santkumar/uPatternScope/hardware/metallic_components/heat_sink/heat_sink_back.jpg

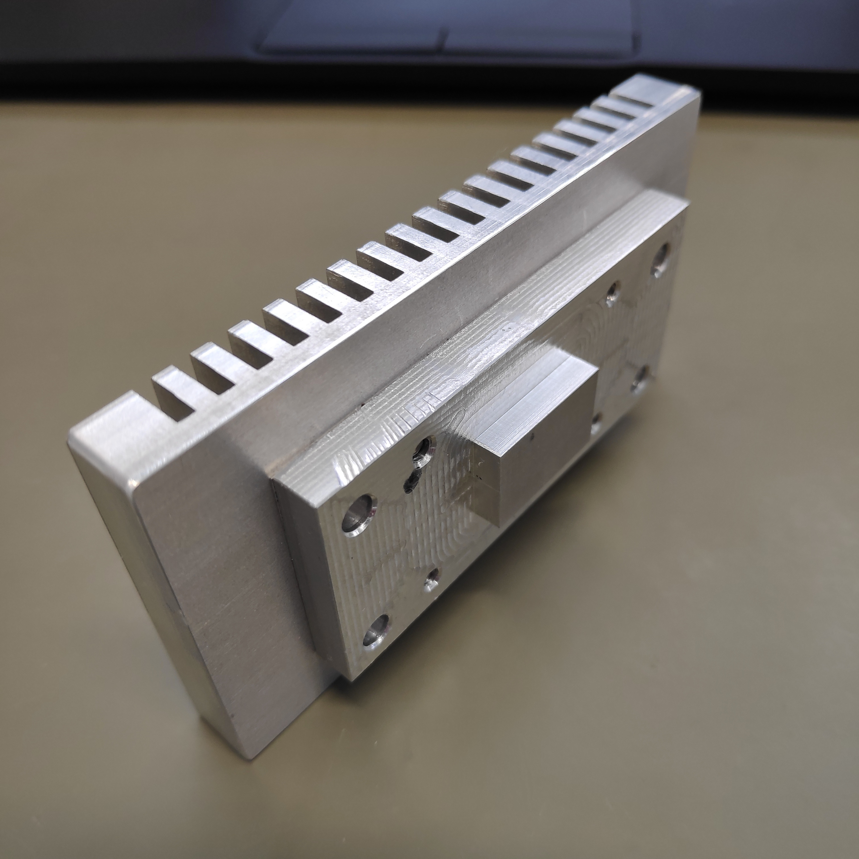
hardware/metallic_components/heat_sink/heat_sink_back.jpg
