santkumar/uPatternScope/README.md

- Hardware: Parts list, CAD designs and related files for the uPatterScope hardware
- Software: Software routines for different demonstration experiments
