santkumar/uPatternScope/hardware/3D_CAD_render1.png

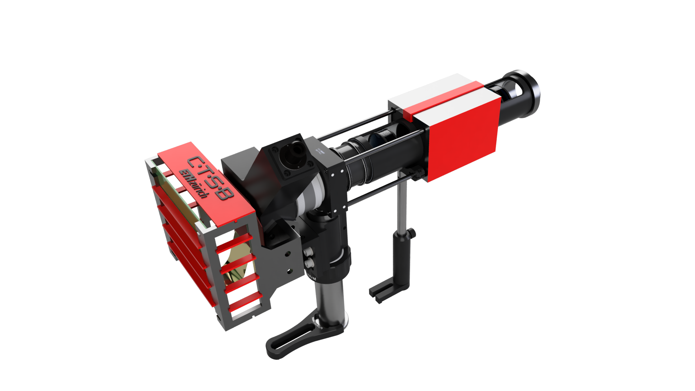
hardware/3D_CAD_render1.png
