santkumar/uPatternScope/hardware/3D_CAD_render2.png

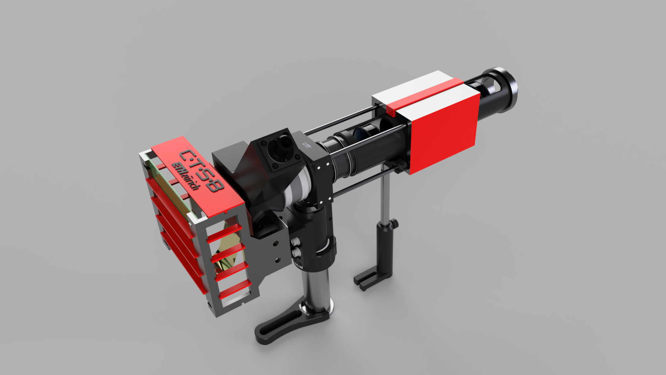
hardware/3D_CAD_render2.png
