santkumar/uPatternScope/software/segmentation_and_pattern_projection/bri_image.png

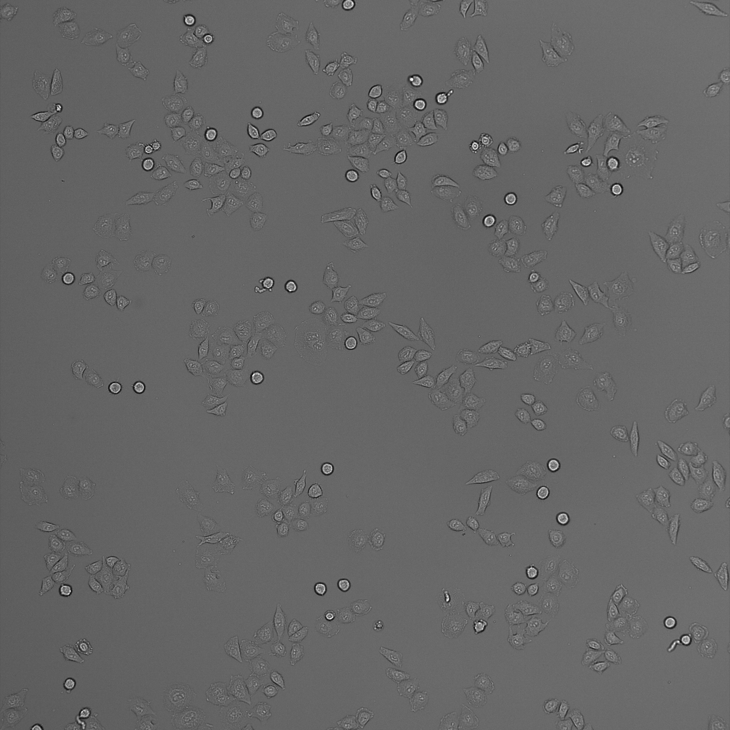
software/segmentation_and_pattern_projection/bri_image.png
