santkumar/uPatternScope/software/segmentation_and_pattern_projection/seg_image.png

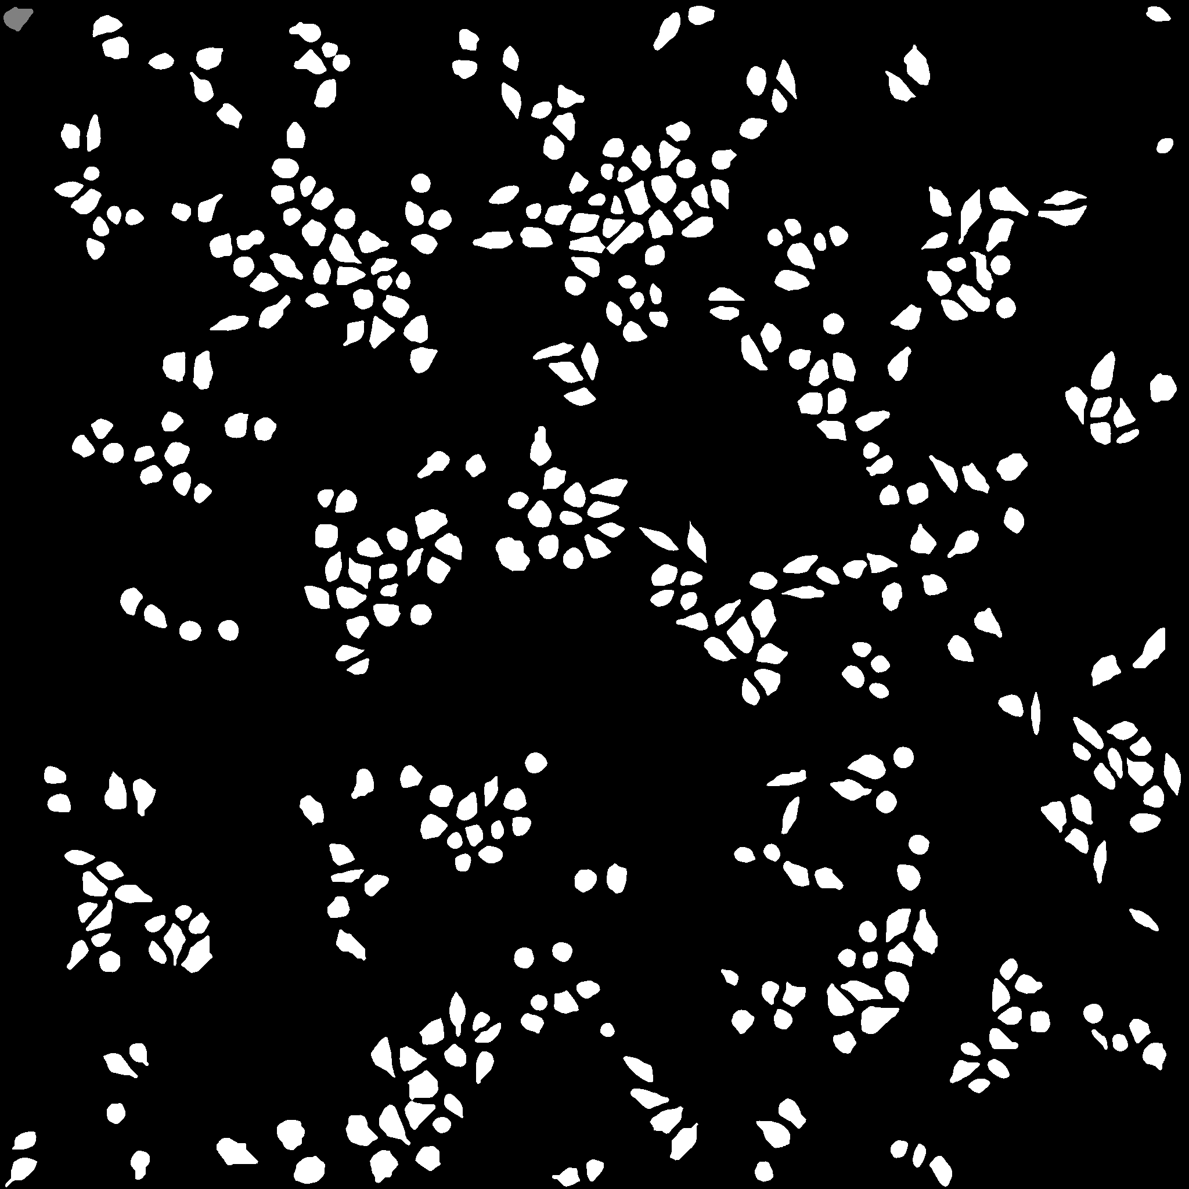
software/segmentation_and_pattern_projection/seg_image.png
