santkumar/uPatternScope/software/segmentation_and_pattern_projection/seg_image.tif

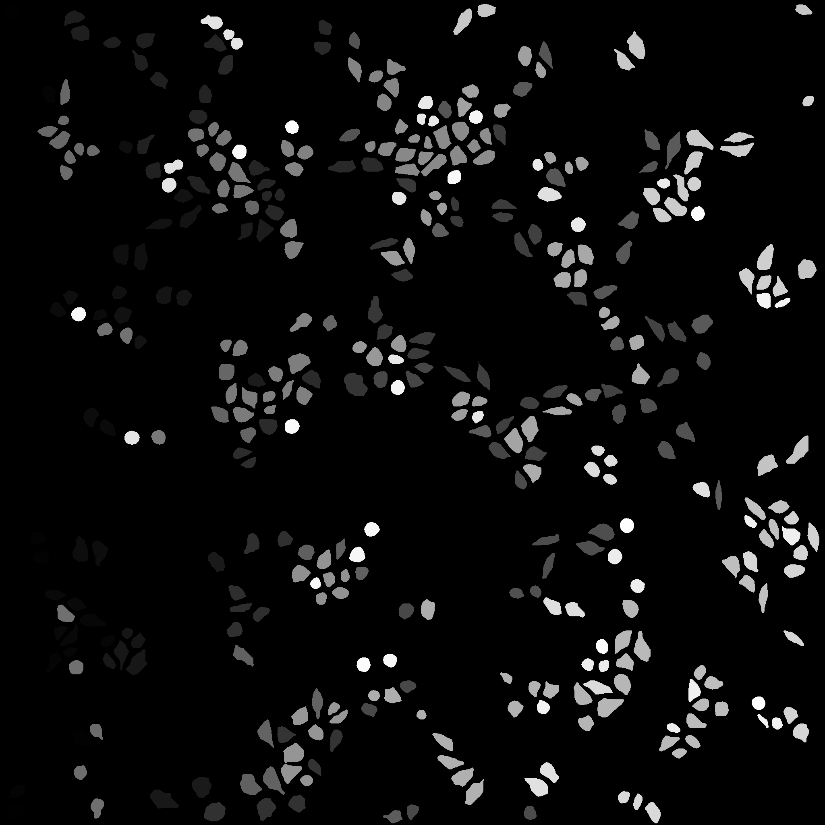
software/segmentation_and_pattern_projection/seg_image.tif
