santkumar/uPatternScope/software/tictactoe_game_matlab_routines/to_project/circle_corrected.png

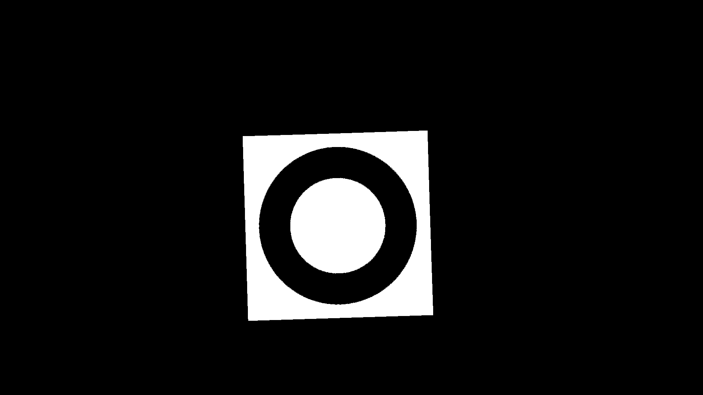
software/tictactoe_game_matlab_routines/to_project/circle_corrected.png
