santkumar/uPatternScope/software/tictactoe_game_matlab_routines/to_project/cross_corrected.png

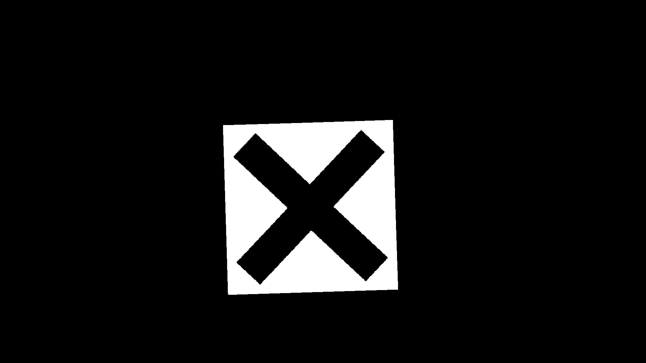
software/tictactoe_game_matlab_routines/to_project/cross_corrected.png
