santkumar/uPatternScope/hardware/Thorlabs_Shopping_Cart.xlsx

Part Number | Item | Product URL | Qty | Price | Subtotal | Currency
M450LP1 | 450 nm 1850 mW (Min) Mounted LED 2000 mA | https://www.thorlabs.com/newgrouppage9.cfm?objectgroup_id=2692 | 1 | 296.08 | 296.08 | Euro
LEDD1B | T-Cube LED Driver 1200 mA Max Drive Current (Power Supply Not Included) | https://www.thorlabs.com/newgrouppage9.cfm?objectgroup_id=2616 | 1 | 294.11 | 294.11 | Euro
KPS101 | 15 V 2.4 A Power Supply Unit with 3.5 mm Jack Connector for One K- or T-Cube | https://www.thorlabs.com/newgrouppage9.cfm?objectgroup_id=1710 | 1 | 32.14 | 32.14 | Euro
SM1L10 | SM1 Lens Tube 1.00" Thread Depth One Retaining Ring Included | https://www.thorlabs.com/newgrouppage9.cfm?objectgroup_id=3307 | 1 | 13.34 | 13.34 | Euro
LLG5-6H | Liquid Light Guide Ø5 mm Core 340 - 800 nm 6' (1.8 m) Length | https://www.thorlabs.com/newgrouppage9.cfm?objectgroup_id=4273 | 1 | 527.23 | 527.23 | Euro
AD5LLG | Ø5 mm LLG to SM1 Adapter | https://www.thorlabs.com/newgrouppage9.cfm?objectgroup_id=4273 | 2 | 31.73 | 63.46 | Euro
XT34SM1 | SM1 Adapter Face Plate for 34 mm Rails Four M3 Screws Included | https://www.thorlabs.com/newgrouppage9.cfm?objectgroup_id=1827 | 1 | 27.54 | 27.54 | Euro
C1515/M | Ø1.5" Mounting Post Bracket M6 Taps | https://www.thorlabs.com/newgrouppage9.cfm?objectgroup_id=1310 | 1 | 97.38 | 97.38 | Euro
HW-KIT2/M | M6 Cap Screw and Hardware Kit | https://www.thorlabs.com/newgrouppage9.cfm?objectgroup_id=248 | 1 | 110.17 | 110.17 | Euro
PSHA/M | Adjustable Height Collar for Ø1.5" Posts M6 x 1.0 Locking Screw | https://www.thorlabs.com/newgrouppage9.cfm?objectgroup_id=1310 | 1 | 62.96 | 62.96 | Euro
C15QR/M | Quick Release Handle 51.4 mm Long M6 x 1.0 Threads | https://www.thorlabs.com/newgrouppage9.cfm?objectgroup_id=9134 | 1 | 9.54 | 9.54 | Euro
RSPC | Fixed Position Retainer | https://www.thorlabs.com/newgrouppage9.cfm?objectgroup_id=47 | 1 | 9.04 | 9.04 | Euro
PB4/M | Studded Pedestal Base Adapter M6 x 1.0 Thread | https://www.thorlabs.com/newgrouppage9.cfm?objectgroup_id=887 | 1 | 12.49 | 12.49 | Euro
PF175B | Clamping Fork for Ø1.5" Pedestal Post or Post Pedestal Base Adapter Universal | https://www.thorlabs.com/newgrouppage9.cfm?objectgroup_id=887 | 1 | 15.45 | 15.45 | Euro
LCP11/M | 60 mm Cage Plate Internal and External SM2 Threads M4 Tap (One SM2RR Retaining Ring Included) | https://www.thorlabs.com/newgrouppage9.cfm?objectgroup_id=3021 | 1 | 95.67 | 95.67 | Euro
SM2L30C | SM2 Slotted Lens Tube 3" Thread Depth 2 Retaining Rings Included | https://www.thorlabs.com/newgrouppage9.cfm?objectgroup_id=3383 | 1 | 88.53 | 88.53 | Euro
SM2T20 | SM2 (2.035"-40) Coupler External Threads 2" Long | https://www.thorlabs.com/newgrouppage9.cfm?objectgroup_id=2704 | 1 | 37.14 | 37.14 | Euro
LCP01/M | 60 mm Cage Plate SM2 Threads 0.5" Thick M4 Tap (Two SM2RR Retaining Rings Included) | https://www.thorlabs.com/newgrouppage9.cfm?objectgroup_id=3021 | 5 | 37.38 | 186.9 | Euro
SM2L20C | SM2 Slotted Lens Tube 2" Thread Depth 2 Retaining Rings Included | https://www.thorlabs.com/newgrouppage9.cfm?objectgroup_id=3383 | 1 | 77.46 | 77.46 | Euro
SM2D25D | SM2 Ring-Actuated Iris Diaphragm (Ø1 - Ø25 mm) | https://www.thorlabs.com/newgrouppage9.cfm?objectgroup_id=1479 | 1 | 81.4 | 81.4 | Euro
LCP01B | 60 mm Cage Mounting Bracket | https://www.thorlabs.com/newgrouppage9.cfm?objectgroup_id=4122 | 1 | 29.27 | 29.27 | Euro
TR150/M | Ø12.7 mm Optical Post SS M4 Setscrew M6 Tap L = 150 mm | https://www.thorlabs.com/newgrouppage9.cfm?objectgroup_id=1266 | 1 | 6.66 | 6.66 | Euro
UPH150/M | Ø12.7 mm Universal Post Holder Spring-Loaded Locking Thumbscrew L = 150 mm | https://www.thorlabs.com/newgrouppage9.cfm?objectgroup_id=1982 | 1 | 35.41 | 35.41 | Euro
LCPA1 | 60 mm Cage Alignment Plate with Ø1 mm Hole | https://www.thorlabs.com/newgrouppage9.cfm?objectgroup_id=7296 | 1 | 17.61 | 17.61 | Euro
CA2824 | SMA Coaxial Cable SMA Male to BNC Male 24" (609 mm) | https://www.thorlabs.com/newgrouppage9.cfm?objectgroup_id=2888 | 1 | 15.83 | 15.83 | Euro
HW-KIT1/M | M4 Cap Screw and Hardware Kit | https://www.thorlabs.com/newgrouppage9.cfm?objectgroup_id=248 | 1 | 55.58 | 55.58 | Euro
ER12 | Cage Assembly Rod 12" Long Ø6 mm | https://www.thorlabs.com/newgrouppage9.cfm?objectgroup_id=4125 | 4 | 15.73 | 62.92 | Euro
AC508-075-A | f = 75 mm Ø2" Achromatic Doublet ARC: 400 - 700 nm | https://www.thorlabs.com/newgrouppage9.cfm?objectgroup_id=120 | 1 | 117.05 | 117.05 | Euro
AC508-100-A | f = 100 mm Ø2" Achromatic Doublet ARC: 400 - 700 nm | https://www.thorlabs.com/newgrouppage9.cfm?objectgroup_id=120 | 1 | 102.3 | 102.3 | Euro
AC508-080-A | f = 80 mm Ø2" Achromatic Doublet ARC: 400 - 700 nm | https://www.thorlabs.com/newgrouppage9.cfm?objectgroup_id=120 | 1 | 117.05 | 117.05 | Euro
MB2025/M | Aluminum Breadboard 200 mm x 250 mm x 12.7 mm M6 Taps | https://www.thorlabs.com/newgrouppage9.cfm?objectgroup_id=159 | 1 | 111.15 | 111.15 | Euro
P150/M | Ø1.5" Mounting Post M6 Taps L = 150 mm | https://www.thorlabs.com/newgrouppage9.cfm?objectgroup_id=1313 | 1 | 49.19 | 49.19 | Euro
P30/M | Ø1.5" Mounting Post M6 Taps L = 30 mm | https://www.thorlabs.com/newgrouppage9.cfm?objectgroup_id=1313 | 1 | 22.13 | 22.13 | Euro
