santkumar/uPatternScope/hardware/metallic_components/heat_sink/heat_sink_front.jpg

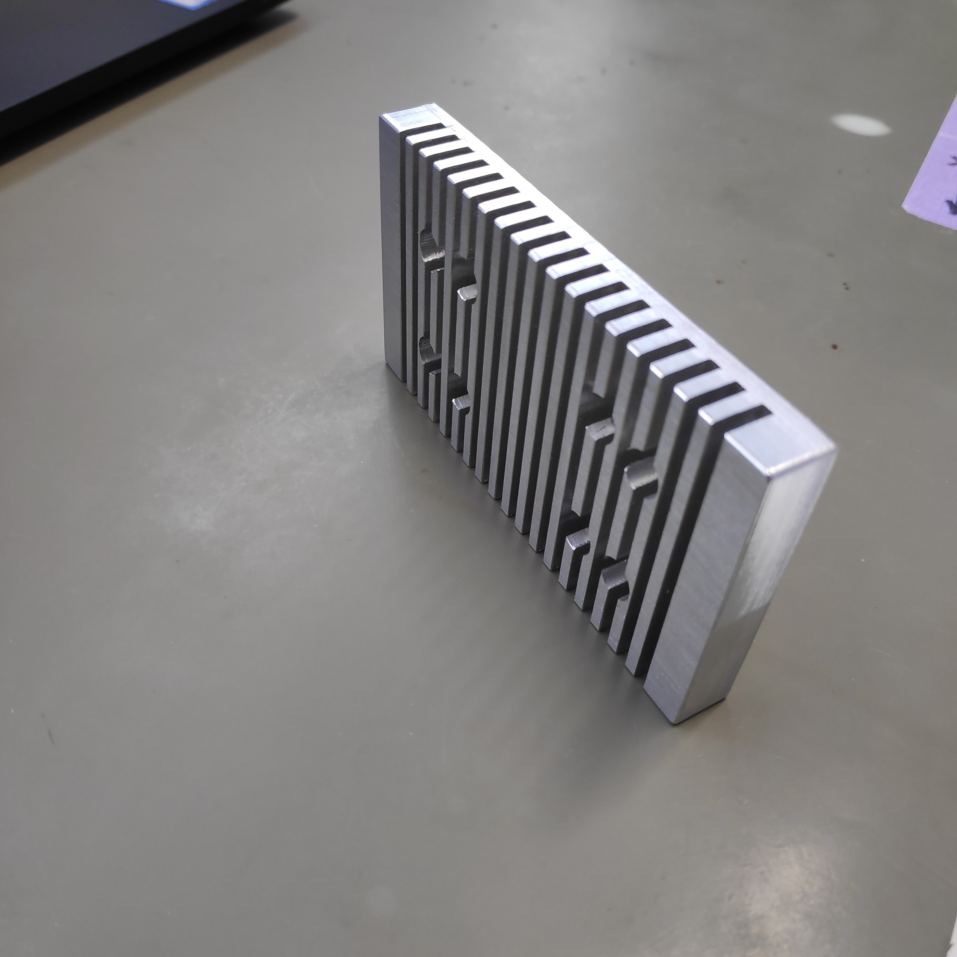
hardware/metallic_components/heat_sink/heat_sink_front.jpg
