santkumar/uPatternScope/hardware/CAD_files_for_3D_print/DMD_fancy_support_optional_2.stl

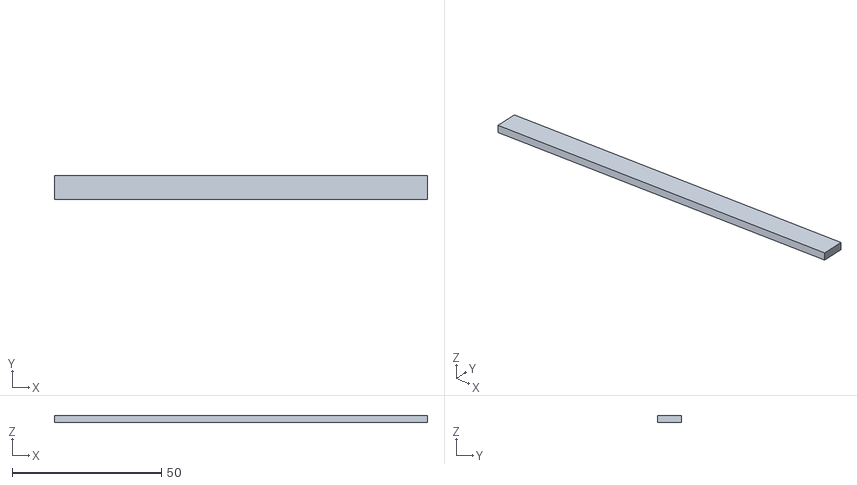
[picture p13: CAD file, 2024-02-26]
hardware/CAD_files_for_3D_print/DMD_fancy_support_optional_2.stl
125.0 x 8.00 x 2.50
