santkumar/uPatternScope/hardware/metallic_components/heat_sink/DMD_heat_sink.STEP

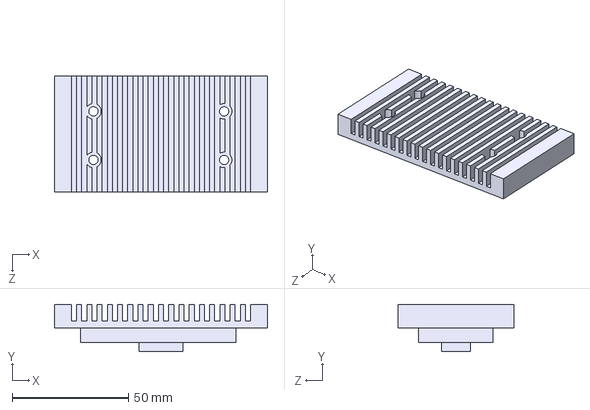
[picture p14: CAD file, 2024-02-26]
hardware/metallic_components/heat_sink/DMD_heat_sink.STEP
91.6 x 20.4 x 50.0 mm
