santkumar/uPatternScope/hardware/metallic_components/microscope_related/NikonTi2_LA_BF_adapter/TI2_LA_BF_adapter.step

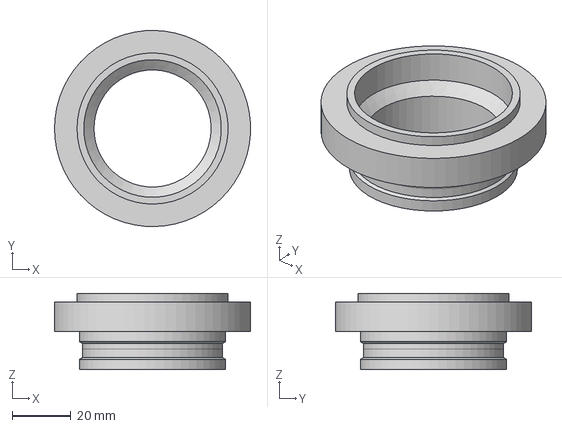
[picture p15: CAD file, 2024-02-26]
hardware/metallic_components/microscope_related/NikonTi2_LA_BF_adapter/TI2_LA_BF_adapter.step
67.0 x 67.0 x 26.0 mm
