santkumar/uPatternScope/hardware/CAD_files_for_3D_print/DMD_board_left_support.step

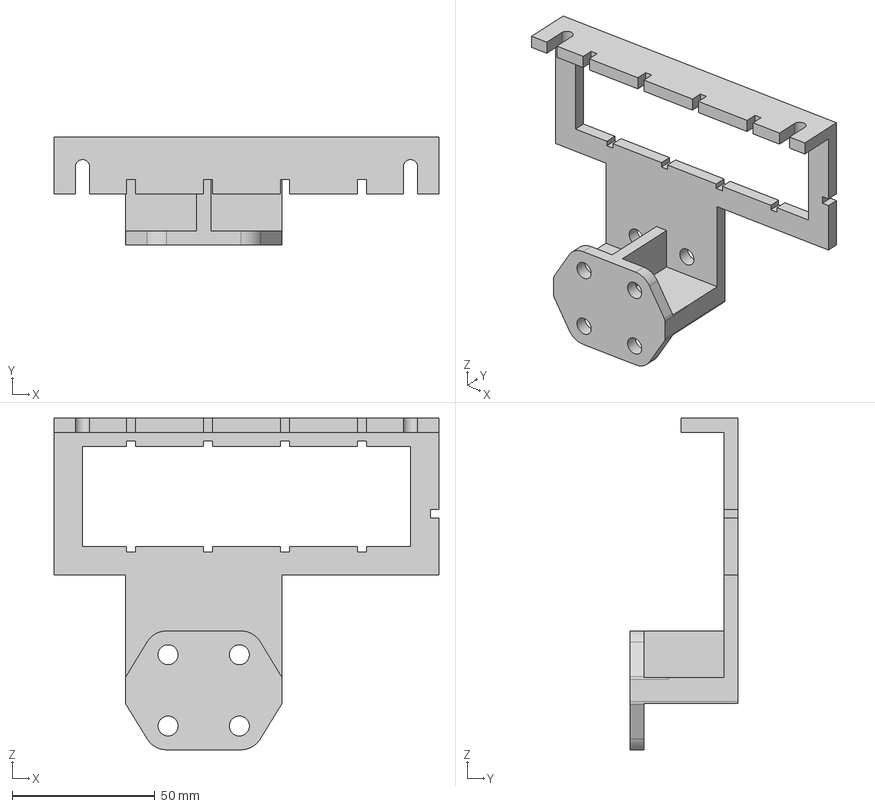
[picture p16: CAD file, 2024-02-26]
hardware/CAD_files_for_3D_print/DMD_board_left_support.step
135.0 x 38.0 x 116.3 mm
