santkumar/uPatternScope/hardware/CAD_files_for_3D_print/DMD_fancy_support_optional_1.stl

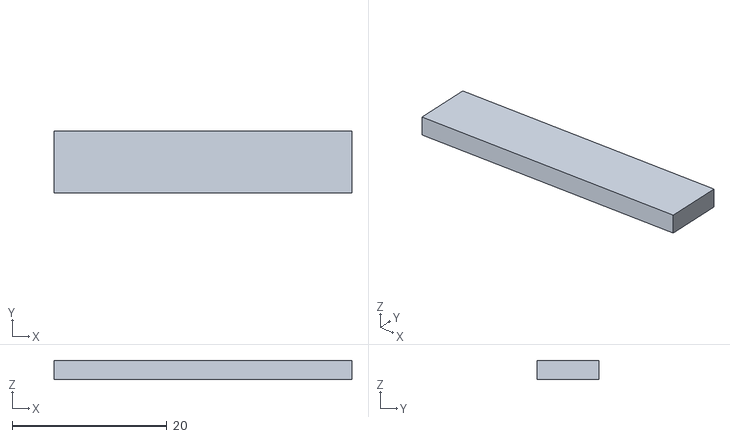
[picture p17: CAD file, 2024-02-26]
hardware/CAD_files_for_3D_print/DMD_fancy_support_optional_1.stl
38.5 x 8.00 x 2.50
