santkumar/uPatternScope/hardware/CAD_files_for_3D_print/DMD_fancy_support_optional.step

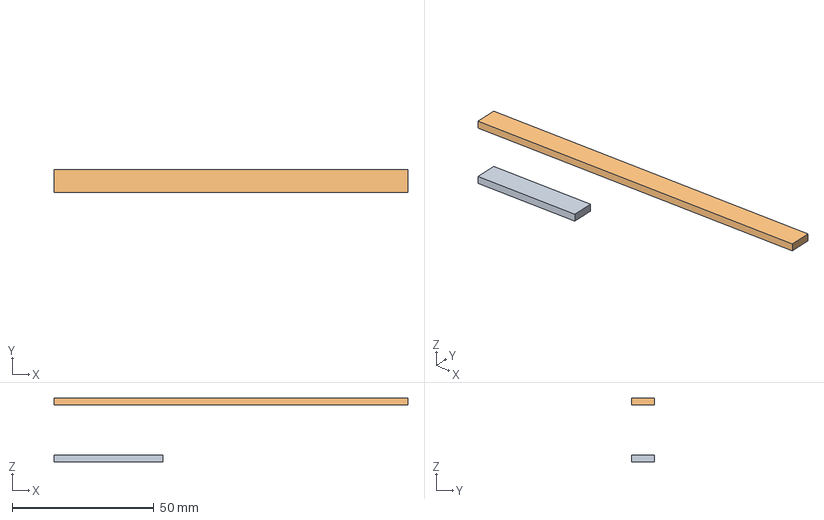
[picture p18: CAD file, 2024-02-26]
hardware/CAD_files_for_3D_print/DMD_fancy_support_optional.step
125.0 x 8.00 x 22.5 mm
