santkumar/uPatternScope/hardware/CAD_files_for_3D_print/optical_cage_cover.step

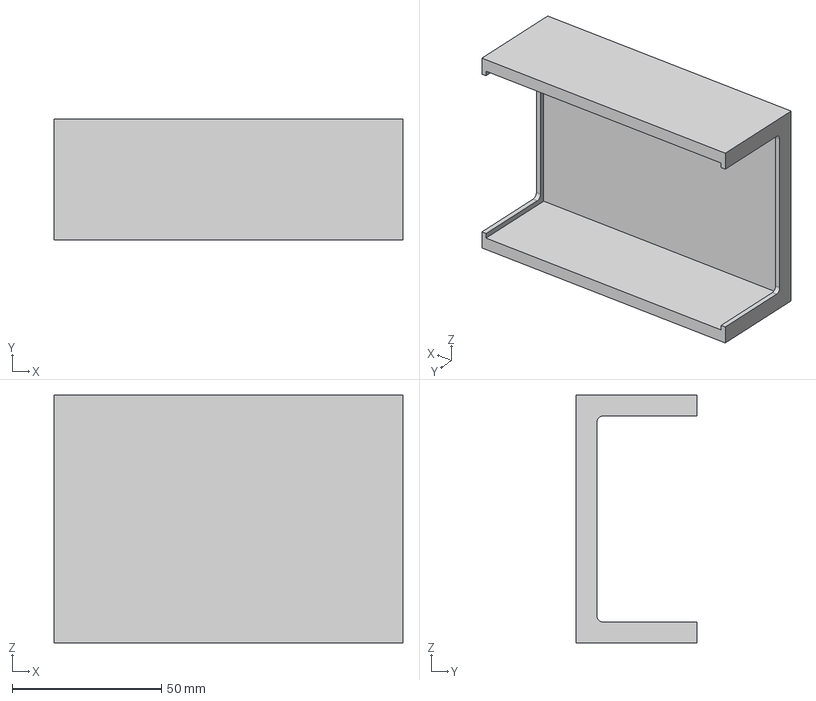
[picture p19: CAD file, 2024-02-26]
hardware/CAD_files_for_3D_print/optical_cage_cover.step
117.0 x 40.5 x 83.0 mm
