santkumar/uPatternScope/hardware/CAD_files_for_3D_print/optical_cage_cover_coupler.step

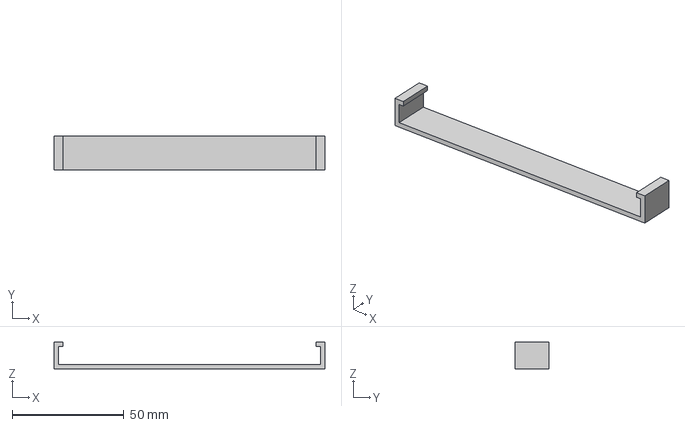
[picture p20: CAD file, 2024-02-26]
hardware/CAD_files_for_3D_print/optical_cage_cover_coupler.step
121.0 x 15.0 x 12.0 mm
