santkumar/uPatternScope/hardware/CAD_files_for_3D_print/logo_cover.step

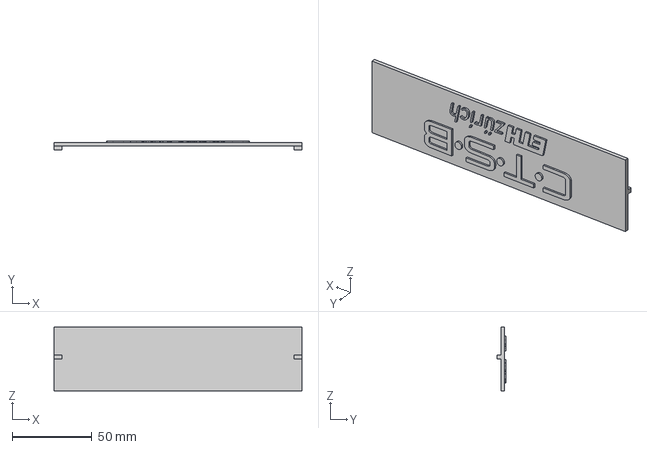
[picture p21: CAD file, 2024-02-26]
hardware/CAD_files_for_3D_print/logo_cover.step
155.5 x 5.50 x 40.0 mm
