santkumar/uPatternScope/hardware/CAD_files_for_3D_print/DMD_board_right_support.step

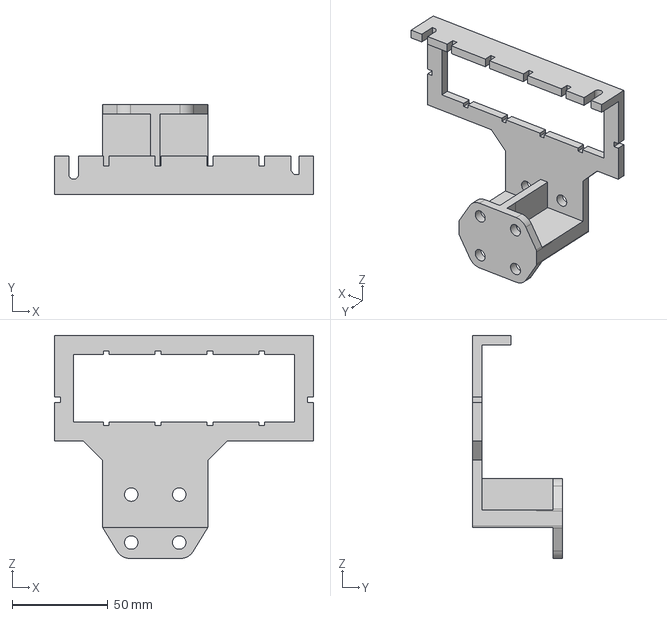
[picture p22: CAD file, 2024-02-26]
hardware/CAD_files_for_3D_print/DMD_board_right_support.step
135.0 x 47.0 x 116.3 mm
