santkumar/uPatternScope/(list of files, cad)

Other CAD files:
software/function_routines/driverDMD/hidapi/hidapi64_thunk_pcwin64.obj
software/segmentation_and_pattern_projection/driverDMD/hidapi/hidapi64_thunk_pcwin64.obj
software/tictactoe_game_matlab_routines/driverDMD/hidapi/hidapi64_thunk_pcwin64.obj
hardware/CAD_files_for_3D_print/DMD_board_left_support.stl
hardware/CAD_files_for_3D_print/DMD_board_right_support.stl
hardware/CAD_files_for_3D_print/logo_cover.stl
hardware/CAD_files_for_3D_print/optical_cage_cover.stl
hardware/CAD_files_for_3D_print/optical_cage_cover_coupler.stl
hardware/metallic_components/heat_sink/DMD_heat_sink.STL
hardware/metallic_components/microscope_related/NikonTi2_LA_BF_adapter/TI2_LA_BF_adapter.stl
