santkumar/uPatternScope/hardware/metallic_components/microscope_related/NikonTi2_LA_BF_adapter/TI2_LA_BF_adapter_technical_drawing.PDF

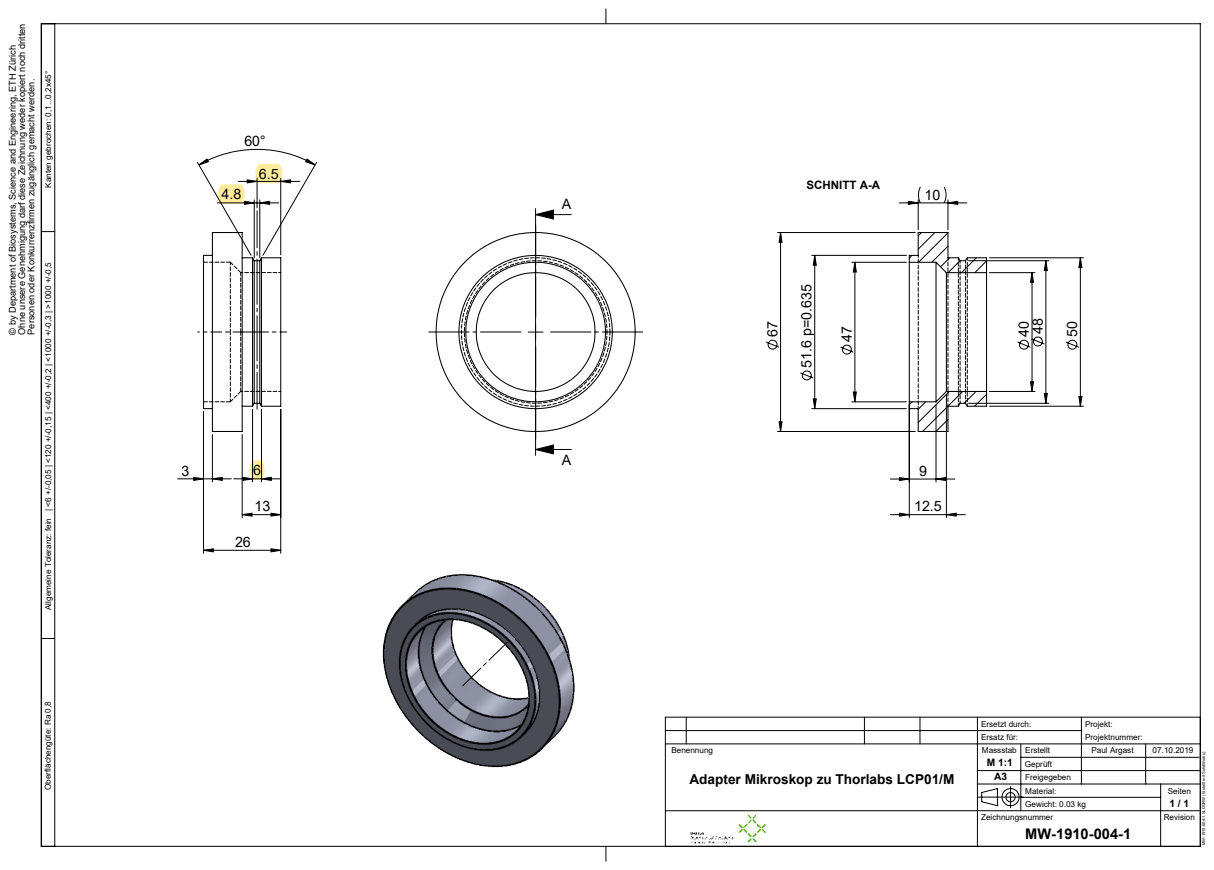
[picture p23: page 1]
10 SCHNITT A-A

Ohne unsere Genehmigung darf diese Zeichnung weder kopiert noch dritten

© by Department of Biosystems, Science and Engineering, ETH Zürich

Oberflächengüte: Ra 0,8 Kanten gebrochen: 0,1...0,2x45° Allgemeine Toleranz: fein | <6 +/-0,05 | <120 +/-0,15 | <400 +/-0,2 | <1000 +/-0,3 | >1000 +/-0,5

Personen oder Konkurrenzfirmen zugänglich gemacht werden.

Ersetzt durch: Projekt: Ersatz für: Projektnummer:

Benennung Adapter Mikroskop zu Thorlabs LCP01/M | Massstab Erstellt Paul Argast 07.10.2019 M 1:1 Geprüft A3 Freigegeben Material: Seiten 1 / 1 Gewicht: 0.03 kg

MW-1910-004-1.SLDDRW (Erstellt mit SolidWorks)

Zeichnungsnummer Revision MW-1910-004-1
