santkumar/uPatternScope/hardware/metallic_components/heat_sink/heat_sink_technical_drawing.pdf

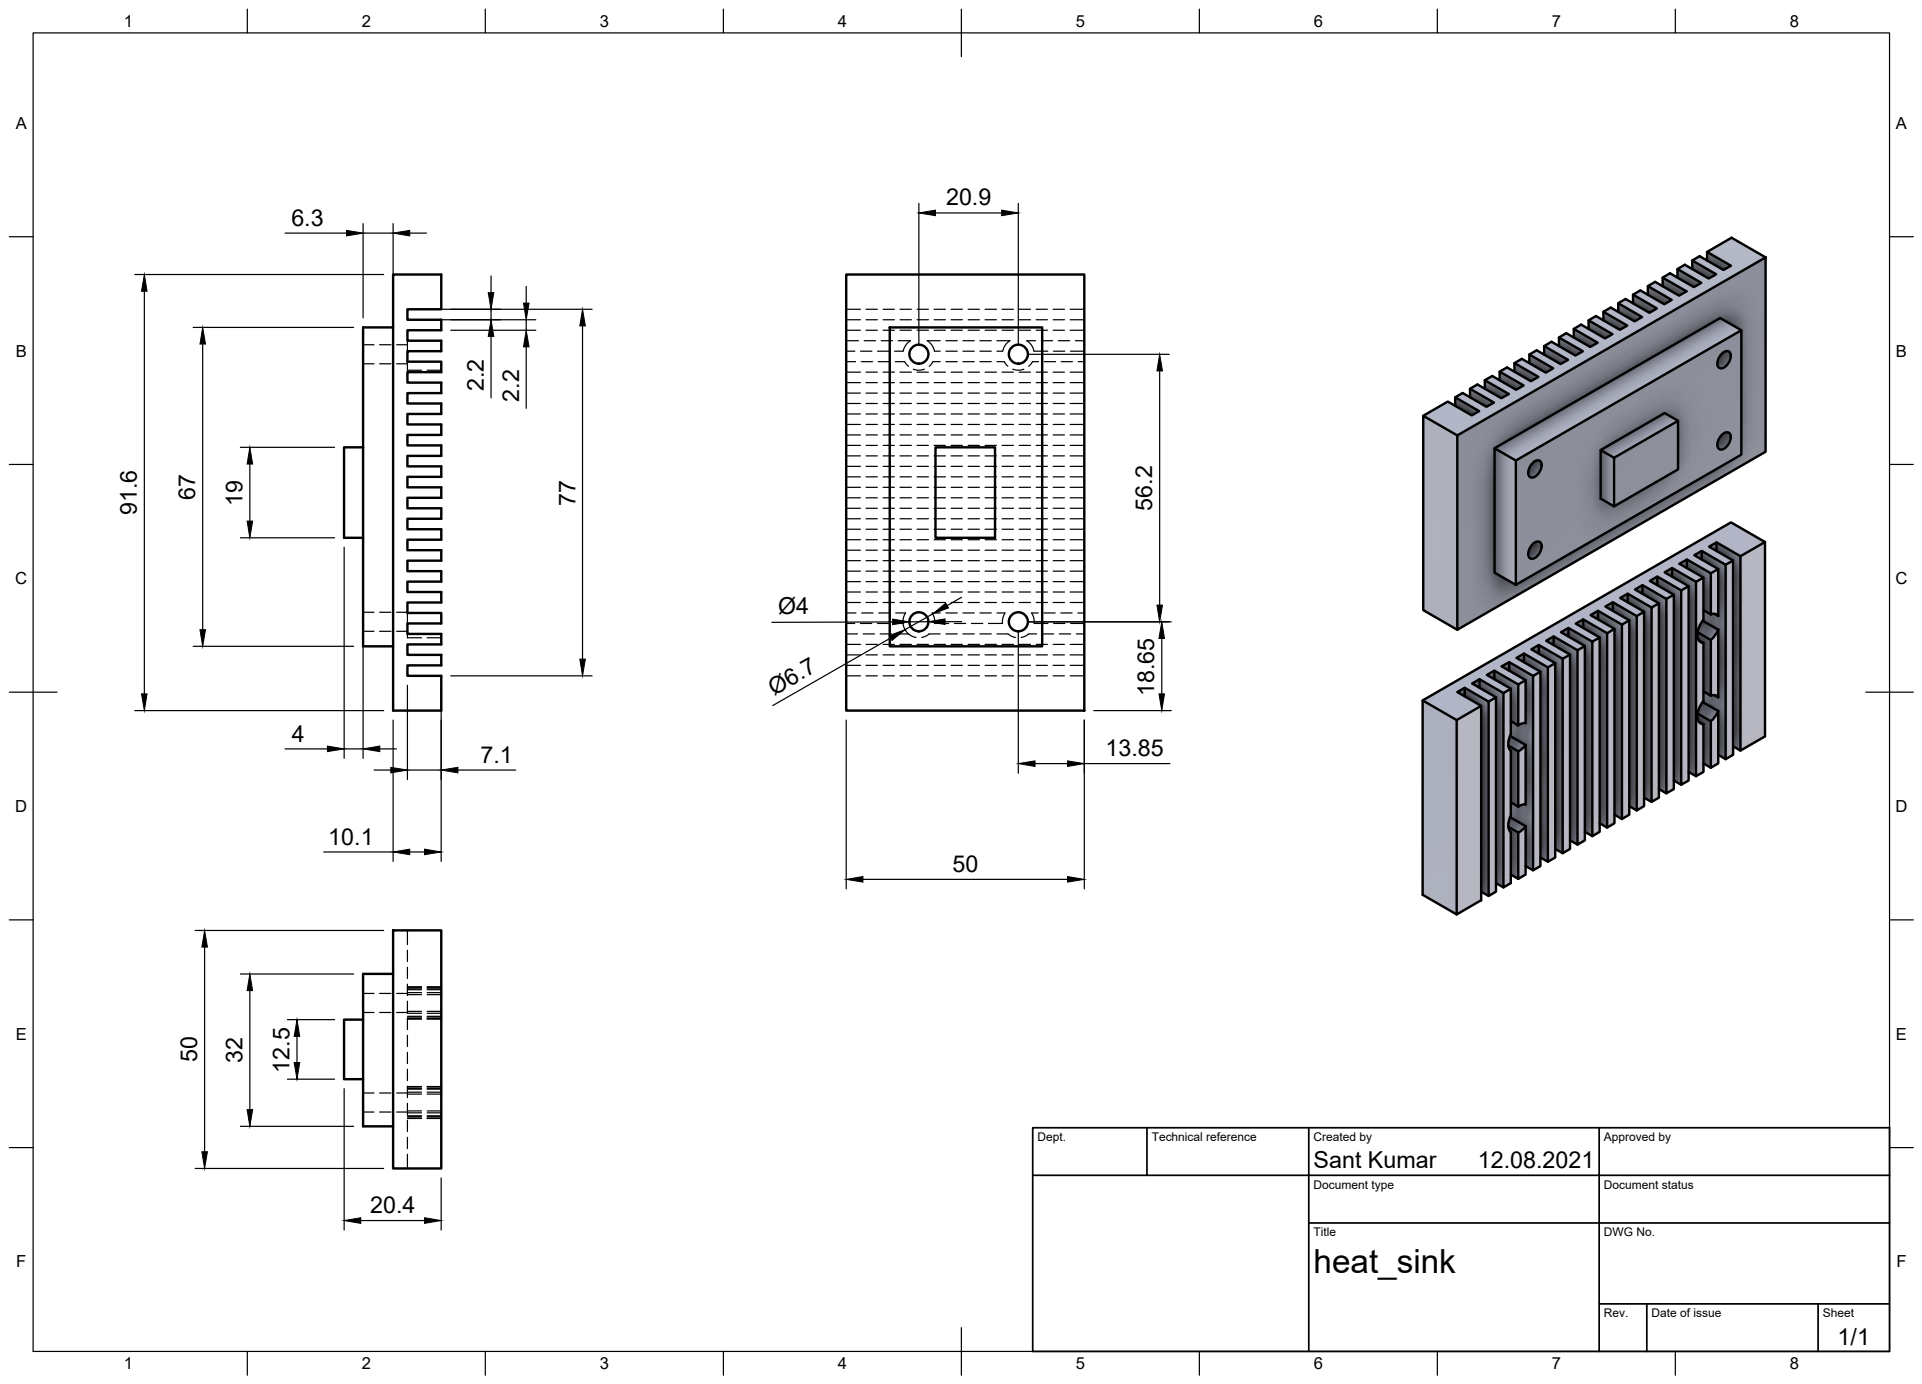
[picture p24: page 1]
Title; DWG No.; Rev.; Date of issue; Sheet; Sant Kumar 91.6

Dept. | Technical reference | Created by 12.08.2021 | Approved by

Document type | Document status
