santkumar/uPatternScope/hardware/CAD_files_for_3D_print/README.md

.step and .stl files for 3D printed parts
