santkumar/uPatternScope/hardware/metallic_components/microscope_related/NikonTi2_LA_BF_adapter/TI2_LA_BF_adapter_assembly.pdf

Microscope part where the adapter attaches:

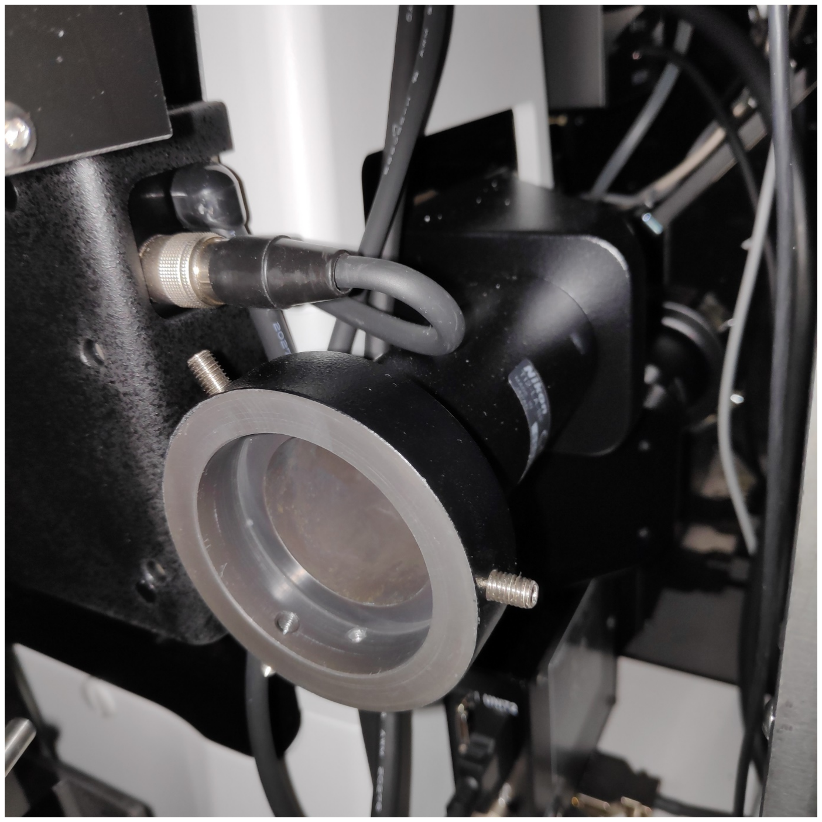
[picture p25: figure]

Microscope part with the adapter attached:

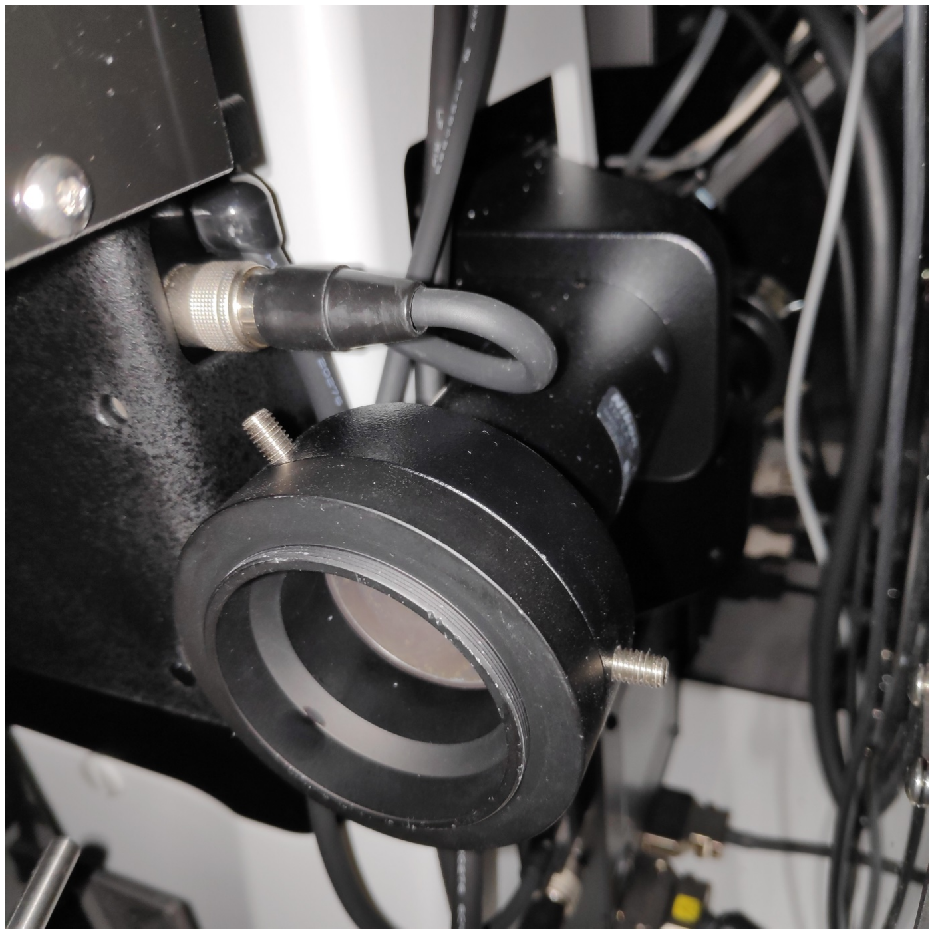
[picture p26: figure]

Microscope part with the adapter and Thorlabs cage plate attached:

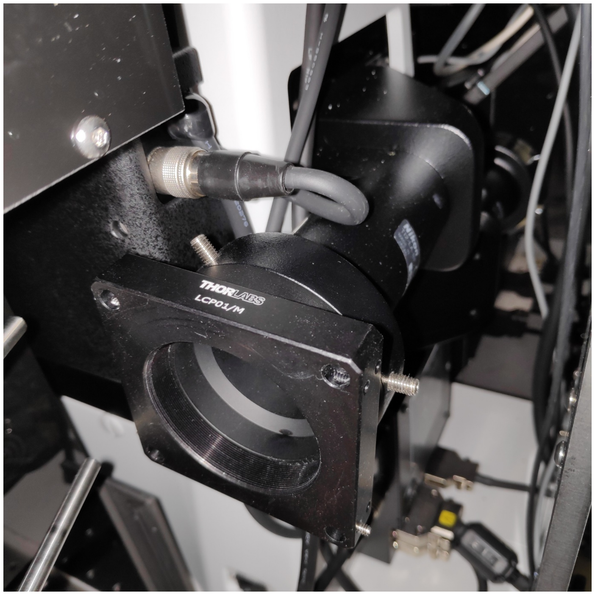
[picture p27: figure]
