santkumar/uPatternScope/software/function_routines/calibration/grid_circles.png

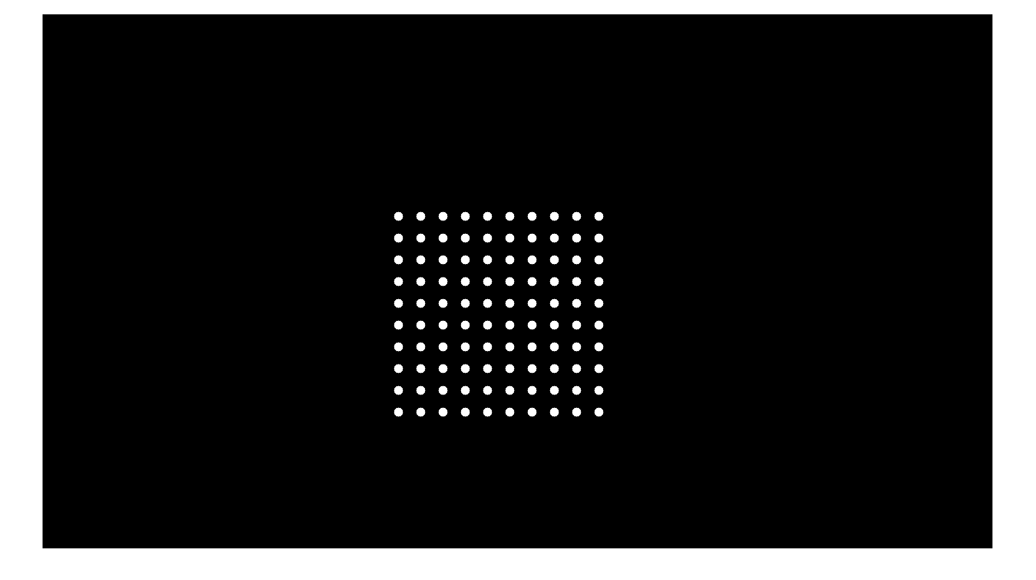
software/function_routines/calibration/grid_circles.png
