santkumar/uPatternScope/(commit log)

2024-02-26 Added CAD files
    [DMD_board_left_support.step, DMD_board_left_support.stl, DMD_board_right_support.step, DMD_board_right_support.stl, DMD_fancy_support_optional.step, DMD_fancy_support_optional_1.stl, DMD_fancy_support_optional_2.stl, logo_cover.step]
2024-02-26 Added heat sink files
    [DMD_heat_sink.STEP, DMD_heat_sink.STL]
2024-02-26 Added microscope adapter files
    [TI2_LA_BF_adapter.step, TI2_LA_BF_adapter.stl]
2024-02-26 Added software routine files
    [hidapi64_thunk_pcwin64.obj, seg_image.csv]
